bwhitman/paper-display/ArduinoEpd/epd.h

/*********************************************************************************************************
*
* File                : epd.h
* Hardware Environment: 
* Build Environment   : RealView MDK-ARM  Version: 4.74
* Version             : V1.0
* By                  : V
*
*                                  (c) Copyright 2005-2015, WaveShare
*                                       http://www.waveshare.net
*                                          All Rights Reserved
*
*********************************************************************************************************/
#ifndef    EPD_H
  #define  EPD_H
	

#define    CMD_SIZE                           512	

/*
frame format
*/
#define    FRAME_B                            0xA5
#define    FRAME_E0                           0xCC
#define    FRAME_E1                           0x33
#define    FRAME_E2                           0xC3
#define    FRAME_E3                           0x3C


/*
color define
*/
#define    WHITE                              0x03
#define    GRAY                               0x02
#define    DARK_GRAY                          0x01
#define    BLACK                              0x00

/*
command define
*/
#define    CMD_HANDSHAKE                      0x00                                                     //handshake
#define    CMD_SET_BAUD                       0x01                                                     //set baud
#define    CMD_READ_BAUD                      0x02                                                     //read baud
#define    CMD_MEMORYMODE                     0x07                                                     //set memory mode
#define    CMD_STOPMODE                       0x08                                                     //enter stop mode 
#define    CMD_UPDATE                         0x0A                                                     //update
#define    CMD_SCREEN_ROTATION                0x0D                                                     //set screen rotation
#define    CMD_LOAD_FONT                      0x0E                                                     //load font
#define    CMD_LOAD_PIC                       0x0F                                                     //load picture

#define    CMD_SET_COLOR                      0x10                                                     //set color
#define    CMD_SET_EN_FONT                    0x1E                                                     //set english font
#define    CMD_SET_CH_FONT                    0x1F                                                     //set chinese font

#define    CMD_DRAW_PIXEL                     0x20                                                     //set pixel
#define    CMD_DRAW_LINE                      0x22                                                     //draw line
#define    CMD_FILL_RECT                      0x24                                                     //fill rectangle
#define    CMD_DRAW_CIRCLE                    0x26                                                     //draw circle
#define    CMD_FILL_CIRCLE                    0x27                                                     //fill circle
#define    CMD_DRAW_TRIANGLE                  0x28                                                     //draw triangle
#define    CMD_FILL_TRIANGLE                  0x29                                                     //fill triangle
#define    CMD_CLEAR                          0x2E                                                     //clear screen use back color

#define    CMD_DRAW_STRING                    0x30                                                     //draw string

#define    CMD_DRAW_BITMAP                    0x70                                                     //draw bitmap


/*
FONT
*/
#define    GBK32                              0x01
#define    GBK48                              0x02
#define    GBK64                              0x03
	
#define    ASCII32                            0x01
#define    ASCII48                            0x02
#define    ASCII64                            0x03



/*
Memory Mode
*/
#define    MEM_NAND                           0
#define    MEM_TF                             1

/*
set screen rotation
*/
#define    EPD_NORMAL                         0                                                        //screen normal
#define    EPD_INVERSION                      1                                                        //screen inversion      


void epd_init(int wake_up_pin);
void epd_reset(void);
void epd_wakeup(void);

void epd_handshake(void);
void epd_set_memory(unsigned char mode);
void epd_enter_stopmode(void);
void epd_udpate(void);
void epd_screen_rotation(unsigned char mode);
void epd_load_font(void);
void epd_load_pic(void);


void epd_set_color(unsigned char color, unsigned char bkcolor);
void epd_set_en_font(unsigned char font);
void epd_set_ch_font(unsigned char font);

void epd_draw_pixel(int x0, int y0);
void epd_draw_line(int x0, int y0, int x1, int y1);
void epd_fill_rect(int x0, int y0, int x1, int y1);
void epd_draw_circle(int x0, int y0, int r);
void epd_fill_circle(int x0, int y0, int r);
void epd_draw_triangle(int x0, int y0, int x1, int y1, int x2, int y2);
void epd_fill_triangle(int x0, int y0, int x1, int y1, int x2, int y2);
void epd_clear(void);

void epd_disp_char(unsigned char ch, int x0, int y0);
void epd_disp_string(const void * p, int x0, int y0);

void epd_disp_bitmap(const void * p, int x0, int y0);


	
#endif
