bwhitman/paper-display/(commit log)

2017-02-10 Waveshare board
2017-02-10 adding ArduinoEpd library
2017-02-10 LED off
